elcano/Sonar/README.md

# Sonar
Range data from an array of ultra-sonic sensors
