elcano/Sonar/Documentation/Sonar_css427_wi2015.pdf

## Scott Stewart, Tim Galvin T. Folsom CSS 427 13 March 2015

# Range Sensor

# Problem Addressed

## The problem addressed by our team was to develop and test the functionality of a sonar board for use in the Elcano project. The sonar board uses multiple sonar sensors simultaneously to gather range data of its surrounding environment. Each sonar board uses

eight sonar sensors: one at each hour of the top half of the clock, and one behind.

## Harmonious operation of sonar sensors, their scope, and communication were problems to

address.

# Work to be Done

Existing datasheets and empirical data were to be used to determine a correct manner to poll sensors in a way that is efficient. The datasheets were also to be used to analyze any overlap of the sonar sensors. Code needed to be written to handle the coordination of the timing of the sonar sensors and the communication between them and the microcontroller using SPI. The code was to be robust and usable by others that work on the Elcano project.

# Solution

## Software Design

Our solution uses an Arduino microcontroller to communicate with the sonar board using SPI bus to coordinate the sonar sensors. The sonar sensors were put into groups of two or three sensors per group. A round of sensor data is gathered by simultaneously getting and reading range data from all sonar sensors in a group. The groups are pinged for data once per round in a set order. As a result, data is received in an orderly manner without much interference between sensors.

## The defined rounds of polling using position on an imaginary clock as position

| Sensor 1 | Sensor 2 | Sensor 3
Round 1 | 12 o’clock | 3 o’clock | 9 o’clock
Round 2 | 1 o’clock | 6 o’clock | 10 o’clock
Round 3 | 2 o’clock | 11 o’clock

## Rounds are handled by driving pins corresponding to a given group HIGH or LOW depending

on which group’s turn it is to get sonar data. This is handled in our setRound() function that takes two integers representing high and low order bits for each group.

The sensors themselves send a PWM signal that is read via an interrupt that records the time length of the signal. This time is then processed and converted into a range measurement in centimeters. This data is then printed.

## Test Methods

We were faced with the problem of testing whether our code worked or not without having the new sonar board on hand. As a solution, we set about building a wooden jig that would hold the sensors in their correct orientation, and allow us to get meaningful readings from them.

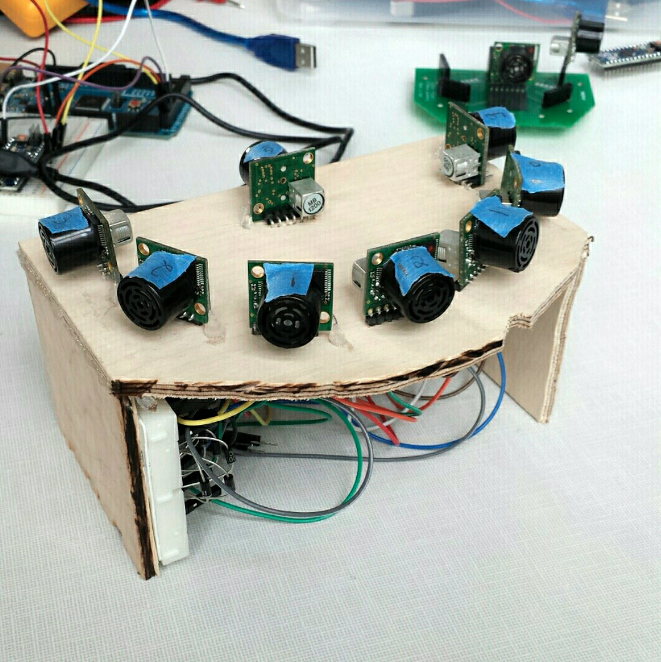
[picture p1: figure]

## Our makeshift “sonarboard”

Once we had the sensors in place, we were able to take the sonar board outside and test our ability to get raw data. In the beginning, this simply meant looking at a series of numbers in the serial monitor. This was useful data, but it was still difficult to convince ourselves that the data was legitimate without some sort of visual.

## Enter processing.org. This opensource project allows for the rapid development of

visualizations, and works very well with serial data. Using built in libraries, we were able adapt

## an example program written by Christan Marc Schmidt [1] (which shows random radii pie

slices) to read serial data and give us a visual of the data from the sonars.

## The program works by reading in a series of values from the given serial port, and then

mapping those values to the radius of a given “slice” of the pie.

Output showing obstacles at 11 and 1 o’clock.

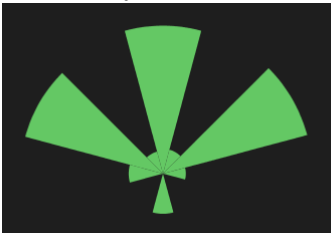
[picture p2: figure]

## We discovered that noise was rampant anytime we tested indoors, but the readings seemed

very reasonable once the board was outdoors.

## Physical/Mechanical Considerations We were aware throughout our testing that our wooden board was likely not ideal for using the sonar sensors. The sensors are angled correctly in terms of yaw, but they are able to

wiggle their pitch somewhat.

Also, our knowledge of circuitry isn’t as robust as our coding experience, and we admit there

## may be some additional circuitry needed for reliable measurements. For example, we spent

many hours wondering why we couldn’t get readings from multiple groups of sensors, only to

## find out that we needed diodes in series with the PWM output from the sensors in order to isolate them from each other. This of course will be a moot point once the new fabricated

sonar boards arrive.

## SPI Communication

We weren’t able to achieve reliable SPI communication in the time that we had. Currently the code will successfully send data over Serial from the sonar arduino.

The interaction of sending a command from the master, having the master wait for a reply, and then reliably sending the 26 bytes needed proved to be very difficult. Simple single byte communication was trivial, and we were able to get data sent from master to slave and back

## again without any issue. However, when we moved to more complicated scenarios, things became more difficult. Here is a series of steps explaining what we were hoping to accomplish:

1. The master sends a command over SPI to the slave, indicating it wants sonar values.

## 2. The slave (sonar arduino) then goes into a mode of reading values from all sonar

sensors. During this time, the master knows to stay idle.

## 3. Finally, the slave has data to send back to the master and begins transmission back

over SPI.
4. The master is intelligent enough to know that the real data has begun being sent back, and stores the data accordingly.

## 5. The communication ends, the slave goes back into idle, and the master does what it

needs to with the data.

## References

## 1. Example Piechart with random radii. http://www.openprocessing.org/sketch/49035

## Source Code

We will post the code here for reporting’s sake, but we will also send the .ino files via Canvas message.

/*sonarboard*/
#defineIRQ2_PIN1 //pulse10,11or12 #defineIRQ2_ID3 //TheinterruptIDrelatingtopin1

#defineIRQ3_PIN0 //Pulseon6or9 #defineIRQ3_ID2 //TheinterruptIDrelatingtopin0

#defineSDA_PIN2// I2CSDA

#defineIRQ1_SCL_PIN3 //Pulseon1,2,or3;orI2C

#defineIRQ1_ID0 | //TheinterruptIDrelatingtopin3

#defineSNR_10_PIN4 //Analogin6isSonar10 #definePWR_SEL_PIN 5 //Use5Vor3.3V #defineSNR_11_PIN6 //Analogin7

#defineRND0_PIN | 11//Loworderbitforselectingtheround

#defineRND1_PIN | 7 //Hibitofroundselect

#definePWR_ON_PIN | 8 //Applypowertosonars

#defineFRONT_PIN | 9 //Donotdisturbifhigh

#defineREAR_PIN | 10 //Donotdisturbifhigh

#defineSNR_SEL_PIN SS //Chipselectfromhostprocessor #defineSNR_SI_PIN MOSI//Thisprocessor'sserialinput

#defineSNR_SO_PIN | MISO//Thisprocessor'sserialoutput

//#defineSNR_12_PIN | A0

//Inthisversionofthecode,weuseA1-A3to //Signalwhichsensorsshouldbetriggeredineach //round.Oncetherealboardarrives,thesecanbe //reclaimedastheroundswillbecontrolledby //ciruitryconnectedtotheRND0_PINandRND1_PINpins
#defineGROUP1_PIN | A1

#defineGROUP2_PIN | A2

#defineGROUP3_PIN | A3

//#defineGROUP2_SEL | A4
//#defineGROUP3_SEL | A5
//#defineSNR_3_PIN | A3
//#defineSNR_6_PIN | A4
//#defineSNR_9_PIN | A5

#defineTIMEOUT_PERIOD100//ms #defineROUND_DELAY100//msbetweenrounds,seemstohelpstability

//Whentrue,senddataoverSerial,falsesenddataoverSPI #defineDEBUGtrue

//WhensedningoverSerial,truegivesverboseoutput #defineVERBOSE_DEBUGfalse

/*Twoboardscanhold12sonarsonthepointsofaclock. ThefrontboardholdsSonar12(straightahead) and1,2,and3Ftotheright.
Italsoholds9F,10,and11totheleft. Therearfacingboardholds3Rthrough9R,with6Rpointingback.

ThefrontsonarboardusestheSPIinterfacetoappearasaslavetoahost computer.
Whenthehostasksforsonarreadings,thefrontboardsendsalldata.

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

Theremaybenorearboardpresent. Inthiscase,thefrontboardmayusethe9F socket.

Sonarsaregroupedintothreeroundssothatmultiplesonarscanfiresimultaneously and
notinteferewitheachother.Roundsareselectedbythe(RND0,RND1)signal, whichisusedasaGraycode(onlyonebitchangesatatime).

Round | Sonars

### 00 none

01 12,3,9
11 1,6,10
10 2,11
Aroundmayfireupto3sonars.Thesonarrangemaybereportedaseitherananalog value
orasapulsewidth.Apulsewidthwillcauseaninterrupt. Therearethreeinterrupthandlers,oneforeachsonarfiredintheround.
*/
//ModifyEXPECTED_SIGNALStomtchwhichsonarsareontheboard. #defineEXPECTED_SIGNALS13
#defineEXPECTED_SIGNALS23

#defineEXPECTED_SIGNALS32

#defineSTATE_INITIAL0

#defineSTATE_READY 1

#defineSTATE_ROUND1 2

#defineSTATE_ROUND2 3

#defineSTATE_ROUND3 4

#defineCOMMAND_GO1

#defineRANGE_DATA_SIZE13

#include"pins_arduino.h"

byteBoardCount=1; //justthefrontboard byteState=STATE_INITIAL;//initializing volatilebyteSignalsReceived; volatileunsignedlongtimeLeft; volatileunsignedlongtimeRight; volatileunsignedlongtimeBehind; volatileunsignedlongtimeStart; volatilebooleantimeStartSet; volatilebytevalueIn;
volatilebooleanprocessIt;

intrange[RANGE_DATA_SIZE]={0,0,0,0,0,0,0,0,0,0,0,0,0}; introundCount=0,timeoutStart=0,timeSinceLastRound=0; volatileintisr1Count,isr2Count,isr3Count;

voidsetup()
{
//SPISetup
pinMode(MISO,OUTPUT);
SPCR|=_BV(SPE);//turnonSPIinslavemode SPCR|=_BV(SPIE);//turnoninterruptsforSPI processIt=false;//falseuntilwehavearequesttoprocess

timeLeft=timeRight=timeBehind=timeStart=0; isr1Count=isr2Count=isr3Count=0; timeStartSet=false;
Serial.begin(115200);
pinMode(A1,OUTPUT);
pinMode(A2,OUTPUT);
pinMode(A3,OUTPUT);
pinMode(0,INPUT);
pinMode(1,INPUT);
pinMode(3,INPUT);
State=STATE_INITIAL;
BoardCount=1;
// | digitalWrite(RND0_PIN,LOW);
// | digitalWrite(RND1_PIN,LOW);
setRound(0,0);
digitalWrite(FRONT_PIN,HIGH); //signalrearboardthatwearehere;Seeifthere isarearboard
//select5Vpower
digitalWrite(PWR_SEL_PIN,HIGH);
//turnonsonars
digitalWrite(PWR_ON_PIN,HIGH);
// | for(inti=0;i<1000;i++)
// | { //Seeifthereisasecondboard
// | byteRear=digitalRead(REAR_PIN);
// | if(Rear==HIGH)
// | {
// | BoardCount=2;
// | //needtodynamicallyattach/detacyIRQ1_SCL_PINsothatitisshared
betweenIntRightandI2C
// | break;
// | }
// | }
| delay(200);//Personardatasheet,needs175msforboot
| attachInterrupt(IRQ2_ID,IsrLeft,CHANGE);
| attachInterrupt(IRQ3_ID,IsrBehind,CHANGE);
| if(BoardCount==1)
| {//don'tneedD3forI2C
| attachInterrupt(IRQ1_ID,IsrRight,CHANGE);
}
| digitalWrite(FRONT_PIN,LOW);//openforbusiness
| State=STATE_READY;
}

//SPIinterruptroutine
ISR(SPI_STC_vect){

valueIn=SPDR; //grabbytefromSPIDataRegister processIt=true;
}

voidIsrLeft()
{ //ISRforendofpulseonsonar10,11or12 isr1Count++;
noInterrupts();
SignalsReceived++;
if(digitalRead(IRQ2_PIN)==HIGH&&timeStartSet==false) {
timeStart=micros();
timeStartSet=true;
}
else
{
timeLeft=micros();
}
interrupts();
}
voidIsrBehind()
{ //ISRforendofpulseonsonar6or9 isr2Count++;
noInterrupts();
SignalsReceived++;
if(digitalRead(IRQ3_PIN)==HIGH&&timeStartSet==false) {
timeStart=micros();
timeStartSet=true;
}
else
{
timeBehind=micros();
}
interrupts();
}
voidIsrRight()
{//ISRforendofpulseonsonar1,2or3 //Logtimeofthepulseend
isr3Count++;
noInterrupts();
SignalsReceived++;
if(digitalRead(IRQ1_SCL_PIN)==HIGH&&timeStartSet==false) {
timeStart=micros();
timeStartSet=true;
}
else

{
timeRight=micros();
}
interrupts();
}

voidloop()
{
State=STATE_READY;
// | digitalWrite(RND0_PIN,LOW);
// | digitalWrite(RND1_PIN,LOW);
| setRound(0,0);
//readInput(); | //Sonarisslavewaitingforcommandfrommaster
//TODO:Sendstartsignaltorearboard.

//******Round1*******
State=STATE_ROUND1;
SignalsReceived=0;
//sendapulseonsonars
interrupts();
setRound(0,1);
// digitalWrite(RND1_PIN,HIGH);

timeoutStart=millis();
while(SignalsReceived<EXPECTED_SIGNALS1)
{
if((millis()-timeoutStart)>TIMEOUT_PERIOD)break; }
delay(ROUND_DELAY);
timeStartSet=false;
range[12]=(timeLeft-timeStart)/58; range[3] =(timeRight-timeStart)/58; range[9] =(timeBehind-timeStart)/58;

//******Round2*******
State=STATE_ROUND2;
SignalsReceived=0;
// | digitalWrite(RND0_PIN,HIGH);
// | sendapulseonsonars
| setRound(1,1);
| timeoutStart=millis();
| while(SignalsReceived<EXPECTED_SIGNALS2)
{

if((millis()-timeoutStart)>TIMEOUT_PERIOD)break; }
delay(ROUND_DELAY);
timeStartSet=false;
range[10]=(timeLeft-timeStart)/58; range[1] =(timeRight-timeStart)/58; range[6] =(timeBehind-timeStart)/58;

//******Round3*******
State=STATE_ROUND3;
// | digitalWrite(RND1_PIN,LOW);
| SignalsReceived=0;
| //sendapulseonsonars
| setRound(0,1);
| timeoutStart=millis();
| while(SignalsReceived<EXPECTED_SIGNALS3)
{
| if((millis()-timeoutStart)>TIMEOUT_PERIOD)break;
}
| delay(ROUND_DELAY);
| timeStartSet=false;
| range[2]=(timeLeft-timeStart)/58;
| range[11] =(timeRight-timeStart)/58;

// //TODO:Receivedatafromrearboard
| writeOutput();
| State=STATE_READY;
| roundCount++;
| //delay(120);
// | return;
}

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

digitalWrite(A3,LOW);
}elseif(highOrderBit==0&&lowOrderBit==1) {
//12,3,9
digitalWrite(A1,HIGH);
digitalWrite(A2,LOW);
digitalWrite(A3,LOW);
delay(10);
digitalWrite(A1,LOW);
}elseif(highOrderBit==1&&lowOrderBit==0) {
//2,11
digitalWrite(A1,LOW);
digitalWrite(A2,HIGH);
digitalWrite(A3,LOW);
delay(10);
digitalWrite(A2,LOW);
}elseif(highOrderBit==1&&lowOrderBit==1) {
//1,6,10
digitalWrite(A1,LOW);
digitalWrite(A2,LOW);
digitalWrite(A3,HIGH);
delay(10);
digitalWrite(A3,LOW);
}
}
voidreadInput()
{
byteselect;
//waitforhosttorequestinformation do
{
select=digitalRead(SNR_SEL_PIN);
}while(select==HIGH);
if(DEBUG)return;
while(!processIt||valueIn!=COMMAND_GO);//stayinroutineuntilcommandedto startonMOSI
processIt=false;
}

voidwriteOutput()
{
if(DEBUG){
if(VERBOSE_DEBUG){
Serial.print("Round:");
Serial.print(roundCount);
Serial.print("millis:");

Serial.print(millis());
Serial.print(",millissincelast:"); Serial.print(millis()-timeSinceLastRound); timeSinceLastRound=millis(); Serial.print(",SigReceived:"); Serial.print(SignalsReceived); Serial.print(",isr1:");
Serial.print(isr1Count);
Serial.print(",isr2:");
Serial.print(isr2Count);
Serial.print(",isr3:");
Serial.print(isr3Count);
Serial.print("Vals:");
}
for(inti=1;i<13;++i)
{
Serial.print(range[i]);
Serial.print("");
}
Serial.println();
}
else
{
//HereiswheredatawillbesentoverSPI.Stillneedswork intdataPos=0;
processIt=false;
while(dataPos<RANGE_DATA_SIZE){ inttimeStart=millis();
while(!processIt){
if(millis()-timeStart>TIMEOUT_PERIOD)break; }
writeIntData(range[dataPos++]);
delay(20);
}
dataPos=0;
}
}

//SendtwobytesoverSPIinordertorepresentanint voidwriteIntData(intdata)
{
bytehighOrderByte=(byte)(data>>8); bytelowOrderByte=(byte)data;

//Sendfirstbyte
SPDR=highOrderByte;
processIt=false;

//WaitforSPIinterruptbeforesedningsecondbyte while(!processIt)
{
if(millis()-timeStart>TIMEOUT_PERIOD)break; }
//Sendsecondbyte
SPDR=lowOrderByte;
processIt=false;
}
