elcano/Sonar/Electronics/SonarBoM_V3.xlsx

Partlist
Exported from SonarBoard Updated.brd at 12/9/2019 8:38 PM
EAGLE Version 9.5.1 Copyright (c) 1988-2019 Autodesk | Inc.
Assembly variant:
Part | Value | Package | Library | Position | Link
C9
C10 | 0.1uF | C025-024X044 | adafruit | (2850.49975 245.19993) R0
C12 | 10uF | C025-024X044 | adafruit | (1429.29995 915.80007) R90
C13 | 10uF | C025-024X044 | adafruit | (2596.0999 246.39998) R0
C14 | DNS | C025-024X044 | adafruit | (2646 115.8002) R0
C16 | 0.1uF | C025-024X044 | adafruit | (2872.89998 1591.50012) R0
C17 | 0.1uF | C025-024X044 | adafruit | (2873.29995 1710.20017) R0
C18 | .1uF | C025-024X044 | rcl | (992.79995 78.79995) R0
C19 | 0.1uF | C025-024X044 | rcl | (992.79995 187.80007) R180
C20 | 0.1uF | C025-024X044 | rcl | (2898.60002 117.9001) R0
C21 | 0.1uF | C025-024X044 | rcl | (3103.2003 245.99988) R0
C22 | 0.1uF | C025-024X044 | rcl | (3149.00012 116.5) R180
C23 | 0.1uF | C025-024X044 | adafruit | (2873.09978 1841.80007) R0
CAN_CLK1 | ECS-160-20-46X | XTAL_ECS-160-20-46X | ECS-160-20-46X | (3466.30007 228.79983) R90
J2 | CAN-PLUG | SCREWTERMINAL-3.5MM-4 | SparkFun-Connectors | (1667.89998 152.70005) R180
J5 | HEAD17-NOSS | HEAD17-NOSS | SmartPrj | (1830.45399 1747.20005) R270
J6 | HEAD17-NOSS-1 | HEAD17-NOSS-1 | SmartPrj | (2428.20399 1747.94993) R270
LED1 |  | LED3MM | adafruit | (616.30007 651.99988) R180
LED2 |  | LED3MM | adafruit | (922.19993 1770.20005) R180
LP38693MP-ADJ | LP38693MP-ADJ | SOT150P696X180-5N | ElcanoProject | (634.9001 907.69993) R0
MCP2510 | MCP2510 | DIL18 | microchip_can | (2134.19993 501.89998) R270
MCP2551 | MCP2551 | DIL08 | MCP2551 | (974.39998 631.40022) R90
R2 | 20k | 0207/9 | adafruit | (1455.10002 557.30007) R270
R3 | 1k | 0207/9 | adafruit | (1635.20017 776.0999) R270
R4 | 120 | 0207/9 | adafruit | (1287.29995 557.79995) R90
R6 | 10k | 0207/9 | adafruit | (945.10015 349.80007) R180
R16 | 600 | 0207/9 | adafruit | (2596.5 1986.10002) R270
R17 | DNS | 0207/9 | adafruit | (2586.70005 1301.30007) R90
R18 | 100k | 0207/9 | adafruit | (677.30007 1151.89998) R180
R19 | DNS | 0207/9 | adafruit | (671.19993 1296.10002) R0
R20 | 33k | 0207/9 | adafruit | (2228.80007 2215.69993) R0
R21 | 12k | 0207/9 | adafruit | (1741.29995 2215.70005) R0
R22 | 600 | 0207/9 | adafruit | (1104.00012 1996.70017) R180
R23 | 0 | 0207/9 | adafruit | (3055.30007 1451.99988) R180
S01 | MaxSonar | XL-MAXSONAR-PACKAGE | ElcanoProject | (2850 2269.92126) R150
S02 | MaxSonar | XL-MAXSONAR-PACKAGE | ElcanoProject | (3490 1624.92126) R120
S03 | MaxSonar | XL-MAXSONAR-PACKAGE | ElcanoProject | (3720 784.92126) R90
S06 | MaxSonar | XL-MAXSONAR-PACKAGE | ElcanoProject | (466.50012 159.29995) R0
S09 | MaxSonar | XL-MAXSONAR-PACKAGE | ElcanoProject | (220 799.92126) R270
S10 | MaxSonar | XL-MAXSONAR-PACKAGE | ElcanoProject | (450 1629.92126) R240
S11 | MaxSonar | XL-MAXSONAR-PACKAGE | ElcanoProject | (1100 2279.92126) R210
S12 | MaxSonar | XL-MAXSONAR-PACKAGE | ElcanoProject | (1968.50394 2508.38583) R180
TP1 | TPPAD1-17 | P1-17 | testpad | (620.49988 1469.99988) R0
TP2 | TPPAD1-17 | P1-17 | testpad | (767.6998 1468.70005) R270
TP3 | TPPAD1-17 | P1-17 | testpad | (213.00037 1304.4001) R0
U1 | SN74LS245N | N20 | SN74LS245 | (1979.1998 2012.70017) R180 | https://www.digikey.com/product-detail/en/texas-instruments/SN74LS245N/296-1655-5-ND/277301
U2 | SN74LS245N | N20 | SN74LS245 | (1681.89998 1154.20005) R0
U4 | SN74LS14N | N14 | SN74LS14 | (2678.5 1058.39998) R180 | https://www.digikey.com/product-detail/en/texas-instruments/SN74LS14N/296-1643-5-ND/277289
U8 | SN74LS139AN | N16 | SN74LS139AN | (3104.3002 1210.4001) R180 | https://www.digikey.com/product-detail/en/texas-instruments/SN74LS139AN/296-1640-5-ND/277286
U9 | CD4075BEG4 | N14 | CD4075BE | (964.29983 1564) R180 | https://www.digikey.com/product-detail/en/texas-instruments/CD4075BEG4/CD4075BEG4-ND/1691340
