elcano/Sonar/Electronics/SonarBoardV3.brd

## EAGLE design Electronics/SonarBoardV3.brd (2019-12-10)

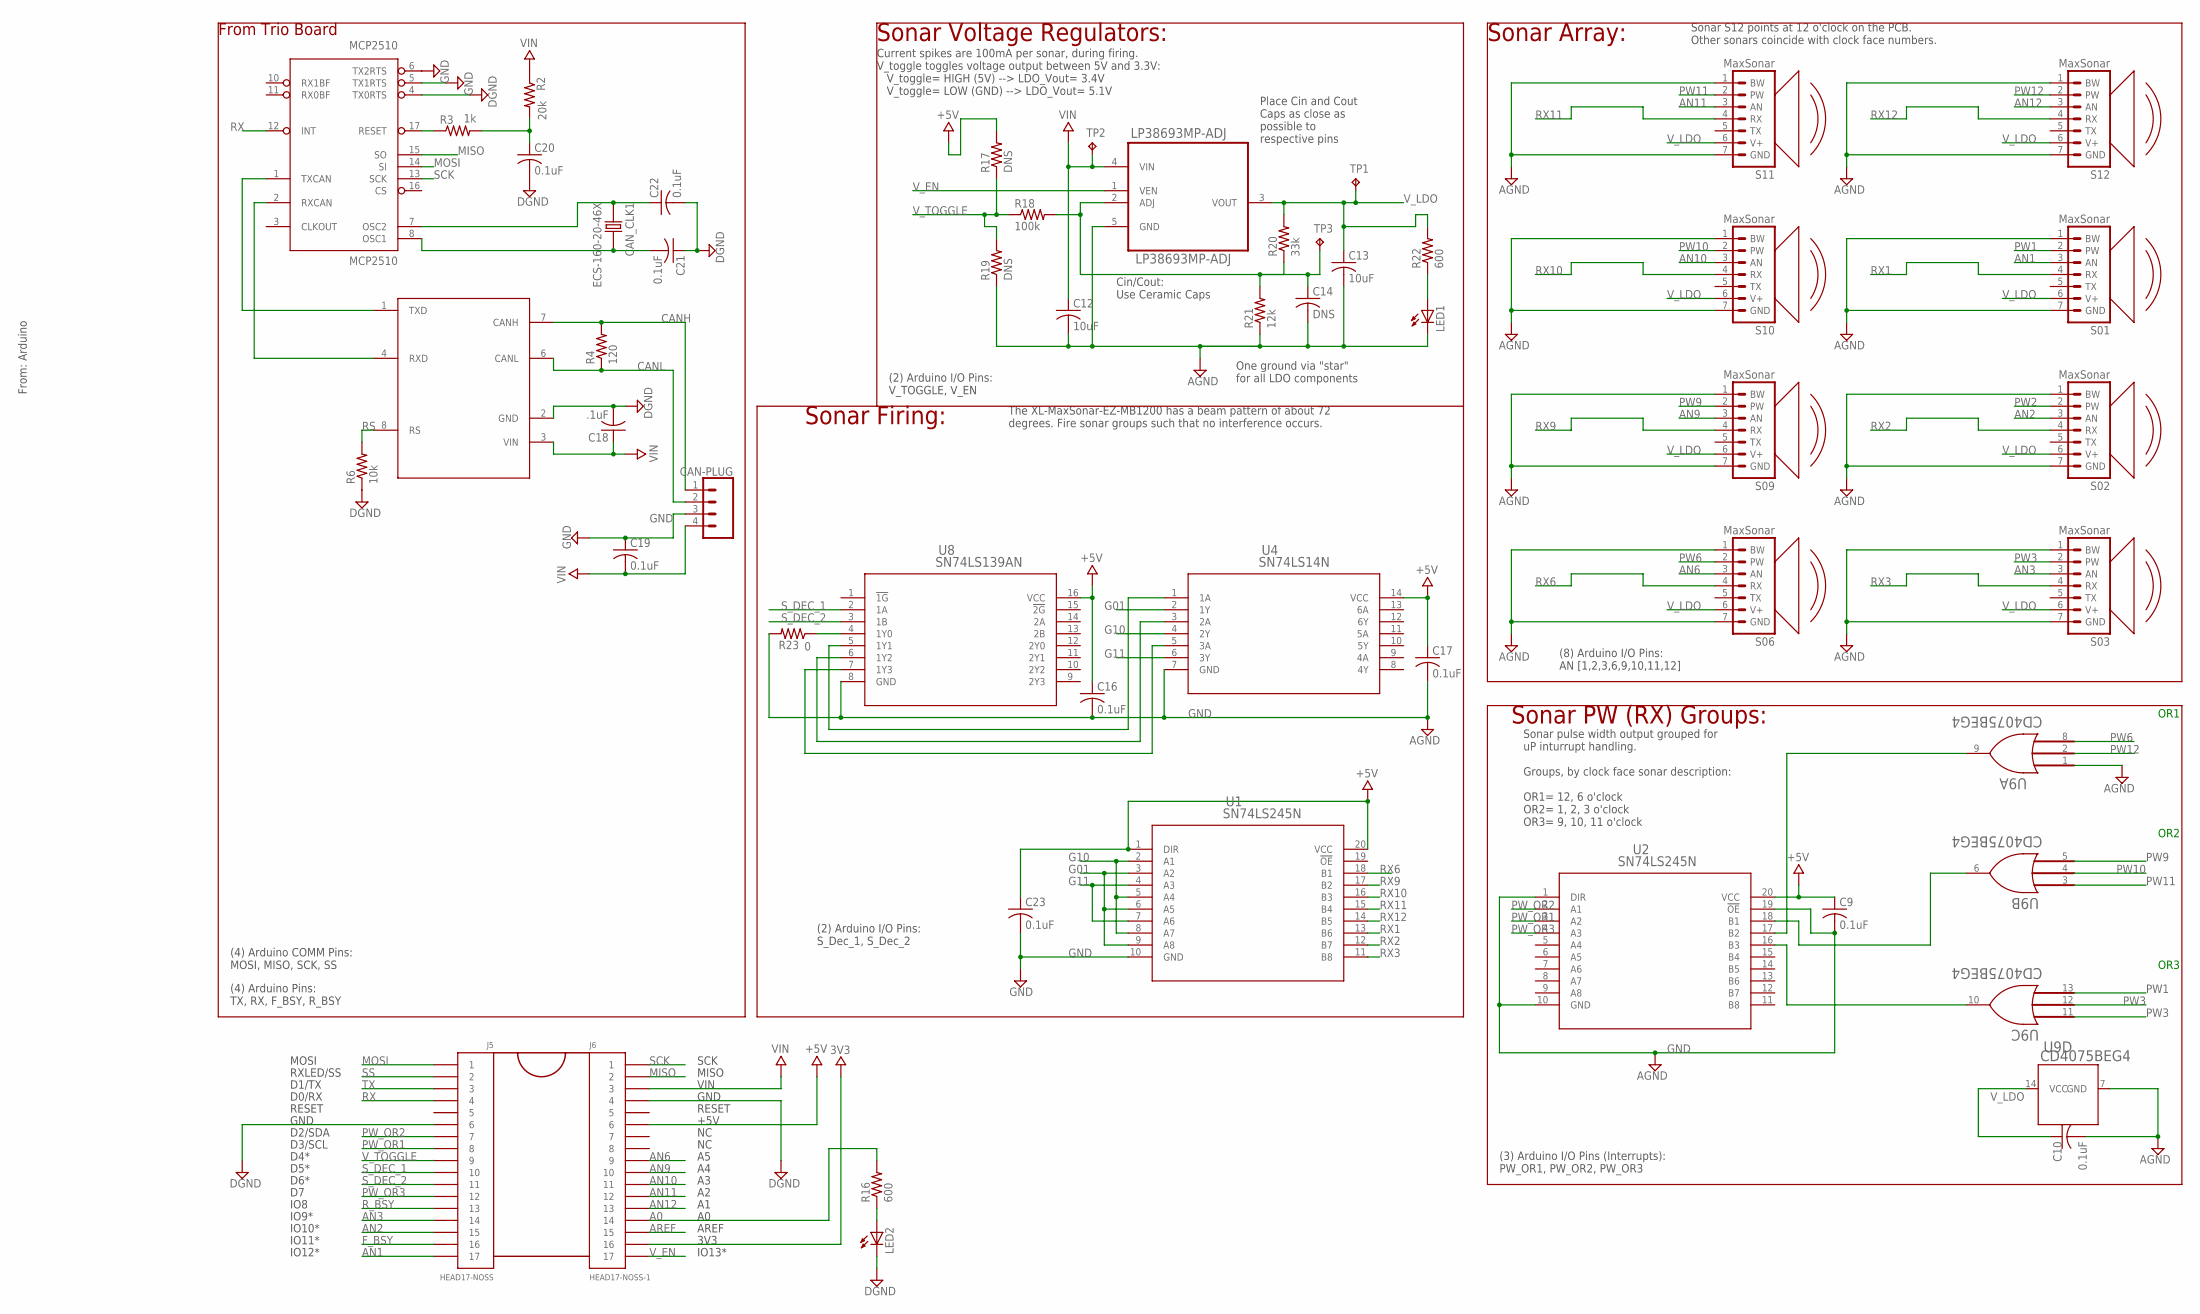
[picture p3: schematic SonarBoardV3.sch]

Parts:
C9, C10, C16, C17, C19, C20, C21, C22, C23: 0.1uF; C025-024X044
C12, C13: 10uF; C025-024X044
C14: DNS; C025-024X044
C18: .1uF; C025-024X044
CAN_CLK1: ECS-160-20-46X; XTAL_ECS-160-20-46X
J2: CAN-PLUG; SCREWTERMINAL-3.5MM-4
J5: HEAD17-NOSS
J6: HEAD17-NOSS-1
LED1, LED2: LED3MM
LP38693MP-ADJ: LP38693MP-ADJ; SOT150P696X180-5N
MCP2510: MCP2510; DIL18
MCP2551: MCP2551; DIL08
R2: 20k; 0207/9
R3: 1k; 0207/9
R4: 120; 0207/9
R6: 10k; 0207/9
R16, R22: 600; 0207/9
R17, R19: DNS; 0207/9
R18: 100k; 0207/9
R20: 33k; 0207/9
R21: 12k; 0207/9
R23: 0; 0207/9
S01, S02, S03, S06, S09, S10, S11, S12: MaxSonar; XL-MAXSONAR-PACKAGE
TP1, TP2, TP3: TPPAD1-17; P1-17
U1, U2: SN74LS245N; N20
U4: SN74LS14N; N14
U8: SN74LS139AN; N16
U9: CD4075BEG4; N14

Connections:
3V3: J6.16
+5V: C9.1, C16.1, C17.1, C23.1, J6.6, R17.2, U1.1 (DIR), U1.20 (VCC), U2.20 (VCC), U4.14 (VCC), U8.16 (VCC)
A0: J6.14, R16.2
AN1: J5.17, S01.3 (AN)
AN2: J5.15, S02.3 (AN)
AN3: J5.14, S03.3 (AN)
AN6: J6.9, S06.3 (AN)
AN9: J6.10, S09.3 (AN)
AN10: J6.11, S10.3 (AN)
AN11: J6.12, S11.3 (AN)
AN12: J6.13, S12.3 (AN)
AREF: J6.15
CANH: J2.1, MCP2551.7 (CANH), R4.2
CANL: J2.2, MCP2551.6 (CANL), R4.1
F_BSY: J5.16
G01: U1.3 (A2), U1.6 (A5), U1.9 (A8), U4.2 (1Y)
G10: U1.2 (A1), U1.5 (A4), U1.8 (A7), U4.4 (2Y)
G11: U1.4 (A3), U1.7 (A6), U4.6 (3Y)
GND: C9.2, C10.2, C12.2, C13.2, C14.2, C16.2, C17.2, C18.2, C19.1, C20.2, C21.1, C22.2, C23.2, J2.3, J5.6, J6.4, LED1.K (C), LED2.K (C), LP38693MP-ADJ.5 (GND), MCP2510.4 (TX0RTS), MCP2510.5 (TX1RTS), MCP2510.6 (TX2RTS), MCP2551.2 (GND), R6.1, R19.1, R21.1, R23.2, S01.1 (BW), S01.7 (GND), S02.1 (BW), S02.7 (GND), S03.1 (BW), S03.7 (GND), S06.1 (BW), S06.7 (GND), S09.1 (BW), S09.7 (GND), S10.1 (BW), S10.7 (GND), S11.1 (BW), S11.7 (GND), S12.1 (BW), S12.7 (GND), U1.10 (GND), U2.1 (DIR), U2.10 (GND), U2.19 (!OE), U4.7 (GND), U8.8 (GND), U9.7 (GND)
MISO: J6.2, MCP2510.15 (SO)
MOSI: J5.1, MCP2510.14 (SI)
unnamed: U4.5 (3A), U8.7 (1Y3)
unnamed: LED2.A, R16.1
unnamed: U2.16 (B3), U9.10 (J)
unnamed: C21.2, CAN_CLK1.2, MCP2510.8 (OSC1)
unnamed: U4.3 (2A), U8.6 (1Y2)
unnamed: LED1.A, R22.1
unnamed: U4.1 (1A), U8.5 (1Y1)
unnamed: C22.1, CAN_CLK1.1, MCP2510.7 (OSC2)
unnamed: MCP2510.2 (RXCAN), MCP2551.4 (RXD)
unnamed: MCP2510.1 (TXCAN), MCP2551.1 (TXD)
unnamed: MCP2510.17 (RESET), R3.1
unnamed: C20.1, R2.2, R3.2
unnamed: R23.1, U8.4 (1Y0)
unnamed: U2.17 (B2), U9.9 (J)
unnamed: U2.18 (B1), U9.6 (J)
PW1: S01.2 (PW)
PW2: S02.2 (PW)
PW3: S03.2 (PW)
PW6: S06.2 (PW)
PW9: S09.2 (PW)
PW10: S10.2 (PW)
PW11: S11.2 (PW)
PW12: S12.2 (PW)
PW_OR1: J5.8, U2.3 (A2)
PW_OR2: J5.7, U2.2 (A1)
PW_OR3: J5.12, U2.4 (A3)
RS: MCP2551.8 (RS), R6.2
RX: J5.4, MCP2510.12 (INT)
RX1: S01.4 (RX), U1.13 (B6)
RX2: S02.4 (RX), U1.12 (B7)
RX3: S03.4 (RX), U1.11 (B8)
RX6: S06.4 (RX), U1.18 (B1)
RX9: S09.4 (RX), U1.17 (B2)
RX10: S10.4 (RX), U1.16 (B3)
RX11: S11.4 (RX), U1.15 (B4)
RX12: S12.4 (RX), U1.14 (B5)
R_BSY: J5.13
SCK: J6.1, MCP2510.13 (SCK)
SS: J5.2
S_DEC_1: J5.10, U8.2 (1A)
S_DEC_2: J5.11, U8.3 (1B)
TX: J5.3
VIN: C12.1, C18.1, C19.2, J2.4, J6.3, LP38693MP-ADJ.4 (VIN), MCP2551.3 (VIN), R2.1, TP2.TP
V_ADJ: C14.1, LP38693MP-ADJ.2 (ADJ), R18.2, R20.1, R21.2, TP3.TP
V_EN: J6.17, LP38693MP-ADJ.1 (VEN)
V_LDO: C10.1, C13.1, LP38693MP-ADJ.3 (VOUT), R20.2, R22.2, S01.6 (V+), S02.6 (V+), S03.6 (V+), S06.6 (V+), S09.6 (V+), S10.6 (V+), S11.6 (V+), S12.6 (V+), TP1.TP, U9.14 (VCC)
V_TOGGLE: J5.9, R17.1, R18.1, R19.2

Notes on the sheet:
Sonar S12 points at 12 o'clock on the PCB. Other sonars coincide with clock face numbers.
From Trio Board
The XL-MaxSonar-EZ-MB1200 has a beam pattern of about 72 degrees. Fire sonar groups such that no interference occurs.
Sonar Voltage Regulators:
Place Cin and Cout Caps as close as possible to respective pins
One ground via "star" for all LDO components
Current spikes are 100mA per sonar, during firing. V_toggle toggles voltage output between 5V and 3.3V: V_toggle= HIGH (5V) --> LDO_Vout= 3.4V V_toggle= LOW (GND) --> LDO_Vout= 5.1V
Cin/Cout: Use Ceramic Caps
From: Arduino
Sonar Firing:
Sonar Array:
(2) Arduino I/O Pins: S_Dec_1, S_Dec_2
(2) Arduino I/O Pins: V_TOGGLE, V_EN
(8) Arduino I/O Pins: AN [1,2,3,6,9,10,11,12]
Sonar PW (RX) Groups:
Sonar pulse width output grouped for uP inturrupt handling. Groups, by clock face sonar description: OR1= 12, 6 o'clock OR2= 1, 2, 3 o'clock OR3= 9, 10, 11 o'clock
(3) Arduino I/O Pins (Interrupts): PW_OR1, PW_OR2, PW_OR3
(4) Arduino COMM Pins: MOSI, MISO, SCK, SS
(4) Arduino Pins: TX, RX, F_BSY, R_BSY
MOSI
RXLED/SS
D1/TX
D0/RX
RESET
GND
D2/SDA
D3/SCL
D4*
D5*
IO8
D6*
IO9*
IO10*
IO11*
IO12*
SCK
MISO
VIN
+5V
AREF
3V3
IO13*
OR1
OR2
OR3

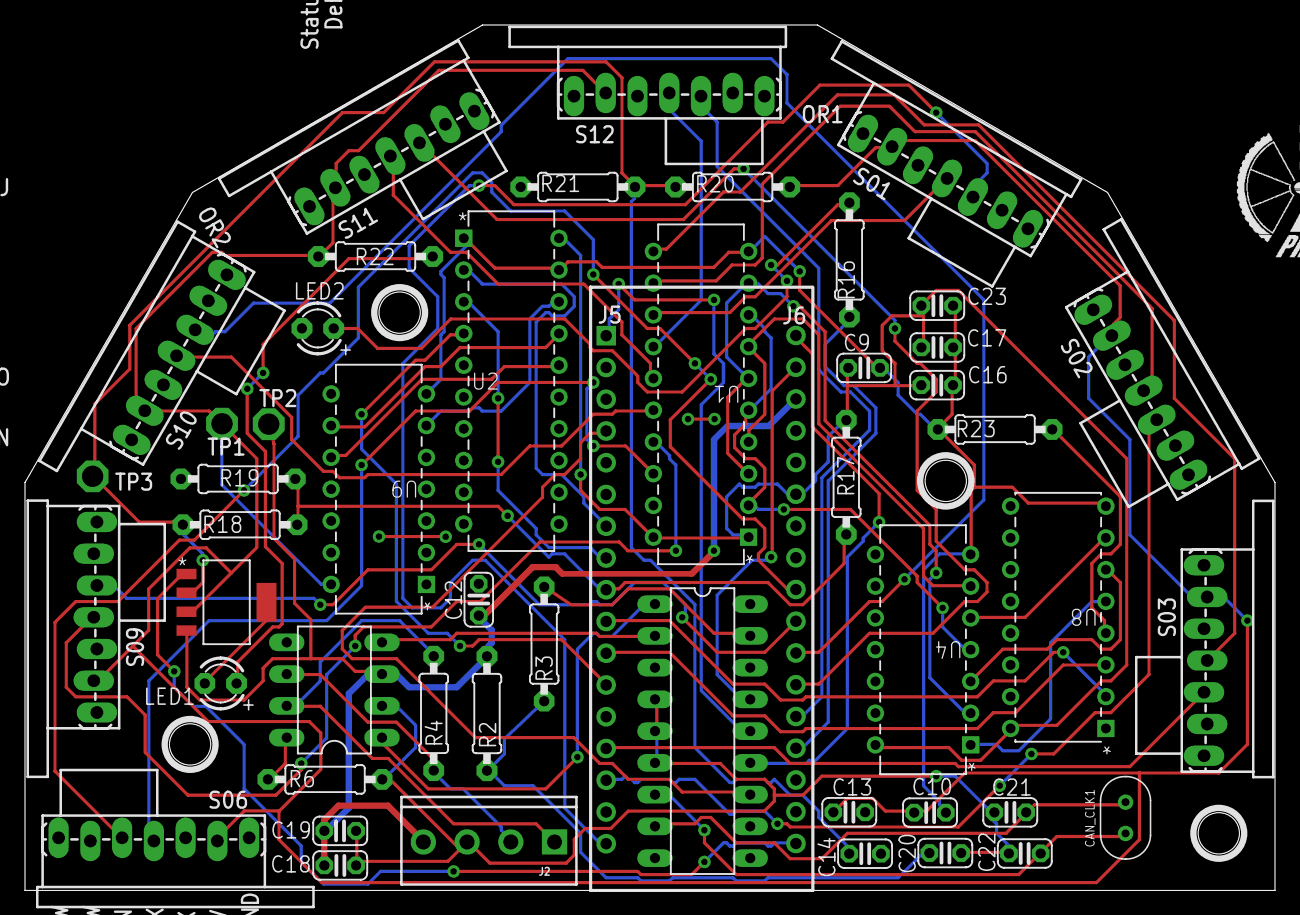
[picture p4: board SonarBoardV3.brd from above]

Board: 2 copper layers, 100.0 x 69.2 mm, 54 parts (0 on the bottom side), 54 nets.

Other parts of the board:
U$15, U$16, U$17, U$18: STAND-OFF
