elcano/Sonar/Electronics/SonarBoardV2.brd

## EAGLE design Electronics/SonarBoardV2.brd (2019-06-20, an earlier design)

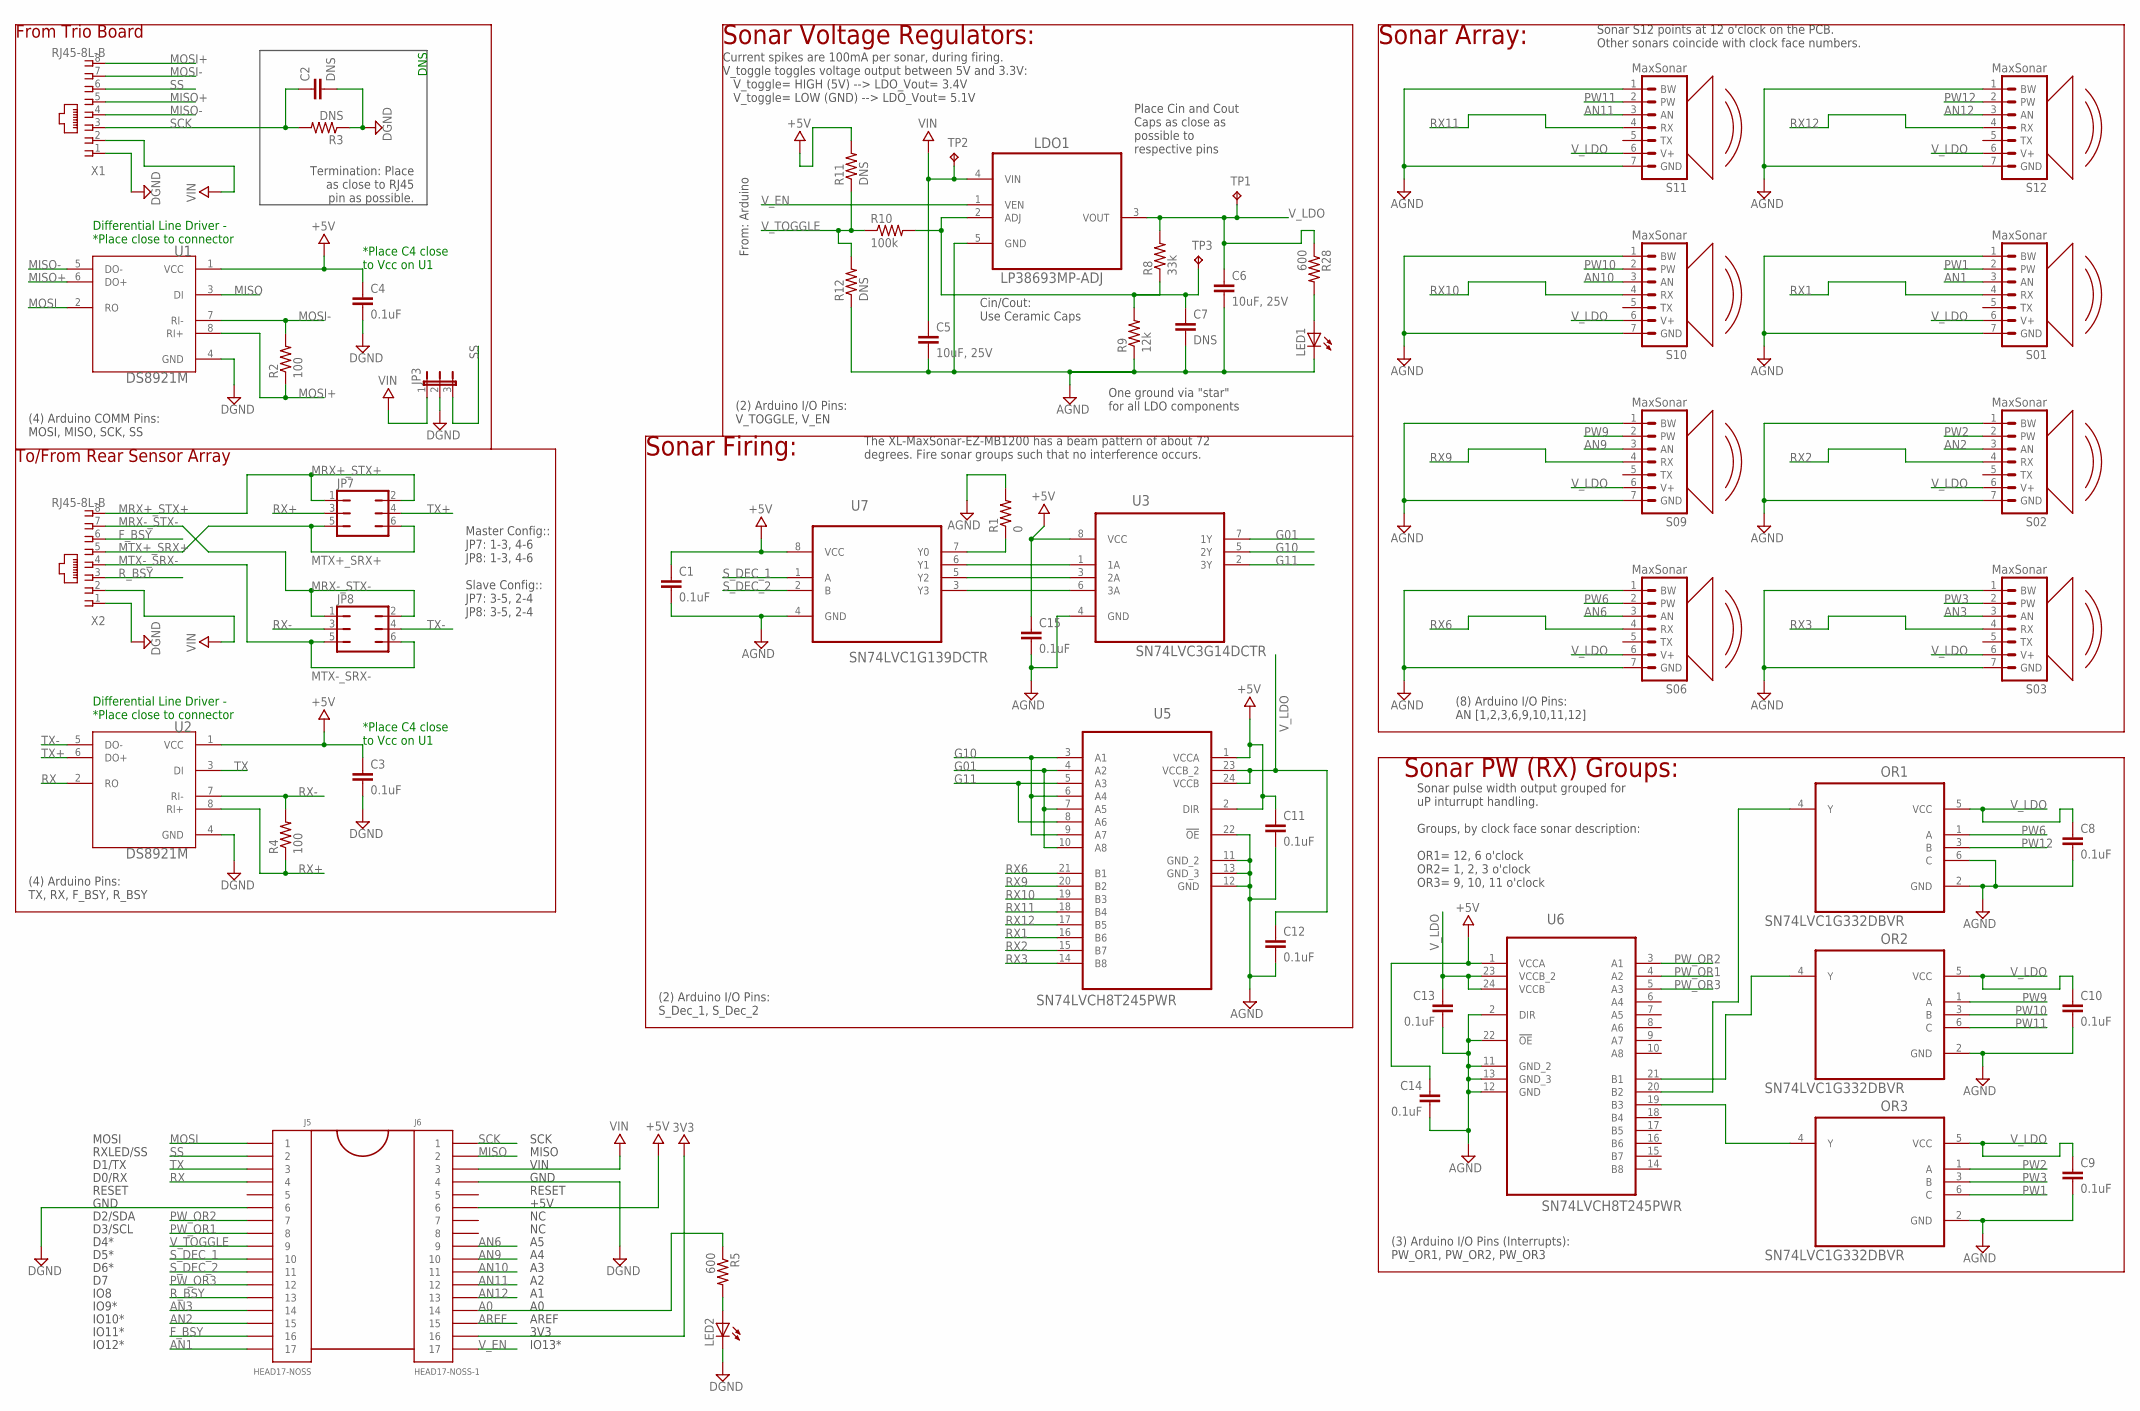
[picture p5: schematic SonarBoardV2.sch]

Parts:
C1, C3, C4, C8, C9, C10, C11, C12, C13, C14, C15: 0.1uF; 0603-CAP
C2, C7: DNS; 0603-CAP
C5, C6: 10uF, 25V; 0805
J5: HEAD17-NOSS
J6: HEAD17-NOSS-1
JP3: JP2E; JP2
JP7, JP8: JP3Q
LDO1: LP38693MP-ADJ; SOT150P696X180-5N
LED1, LED2: LEDSML0603; SML0603
OR1, OR2, OR3: SN74LVC1G332DBVR; SOT95P280X145-6N
R1: 0; 0603-RES
R2, R4: 100; R0805
R3, R11, R12: DNS; 0603-RES
R5, R28: 600; 0603-RES
R8: 33k; 0603-RES
R9: 12k; 0603-RES
R10: 100k; 0603-RES
S01, S02, S03, S06, S09, S10, S11, S12: MaxSonar; XL-MAXSONAR-PACKAGE
TP1, TP2, TP3: TPPAD1-17; P1-17
U1, U2: DS8921M; SOIC127O620X175-8N
U3: SN74LVC3G14DCTR; SOP65P400X130-8N
U5, U6: SN74LVCH8T245PWR; SOP65P640X120-24N
U7: SN74LVC1G139DCTR; SOP65P400X130-8N@1
X1, X2: RJ45-8L-B; RJ45-NO-SHIELD

Connections:
3V3: J6.16
+5V: C1.1, C3.1, C4.1, C11.1, C14.1, C15.1, J6.6, R11.2, U1.1 (VCC), U2.1 (VCC), U3.8 (VCC), U5.1 (VCCA), U5.2 (DIR), U6.1 (VCCA), U7.8 (VCC)
A0: J6.14, R5.1
AN1: J5.17, S01.3 (AN)
AN2: J5.15, S02.3 (AN)
AN3: J5.14, S03.3 (AN)
AN6: J6.9, S06.3 (AN)
AN9: J6.10, S09.3 (AN)
AN10: J6.11, S10.3 (AN)
AN11: J6.12, S11.3 (AN)
AN12: J6.13, S12.3 (AN)
AREF: J6.15
F_BSY: J5.16, X2.6
G01: U3.7 (1Y), U5.4 (A2), U5.7 (A5), U5.10 (A8)
G10: U3.5 (2Y), U5.3 (A1), U5.6 (A4), U5.9 (A7)
G11: U3.2 (3Y), U5.5 (A3), U5.8 (A6)
GND: C1.2, C2.2, C3.2, C4.2, C5.2, C6.2, C7.2, C8.2, C9.2, C10.2, C11.2, C12.2, C13.2, C14.2, C15.2, J5.6, J6.4, JP3.2, LDO1.5 (GND), LED1.C, LED2.C, OR1.2 (GND), OR1.6 (C), OR2.2 (GND), OR3.2 (GND), R1.2, R3.1, R9.1, R12.1, S01.1 (BW), S01.7 (GND), S02.1 (BW), S02.7 (GND), S03.1 (BW), S03.7 (GND), S06.1 (BW), S06.7 (GND), S09.1 (BW), S09.7 (GND), S10.1 (BW), S10.7 (GND), S11.1 (BW), S11.7 (GND), S12.1 (BW), S12.7 (GND), U1.4 (GND), U2.4 (GND), U3.4 (GND), U5.11 (GND_2), U5.12 (GND), U5.13 (GND_3), U5.22 (!OE), U6.2 (DIR), U6.11 (GND_2), U6.12 (GND), U6.13 (GND_3), U6.22 (!OE), U7.4 (GND), X1.1, X2.1
MISO: J6.2, U1.3 (DI)
MISO+: U1.6 (DO+), X1.5
MISO-: U1.5 (DO-), X1.4
MOSI: J5.1, U1.2 (RO)
MOSI+: R2.1, U1.8 (RI+), X1.8
MOSI-: R2.2, U1.7 (RI-), X1.7
MRX+_STX+: JP7.1, JP7.2, X2.8
MRX-_STX-: JP8.1, JP8.2, X2.7
MTX+_SRX+: JP7.5, JP7.6, X2.5
MTX-_SRX-: JP8.5, JP8.6, X2.4
unnamed: LED2.A, R5.2
unnamed: LED1.A, R28.2
unnamed: U3.1 (1A), U7.6 (Y1)
unnamed: U3.3 (2A), U7.5 (Y2)
unnamed: U3.6 (3A), U7.3 (Y3)
unnamed: R1.1, U7.7 (Y0)
unnamed: OR1.4 (Y), U6.20 (B2)
unnamed: OR2.4 (Y), U6.21 (B1)
unnamed: OR3.4 (Y), U6.19 (B3)
PW1: OR3.6 (C), S01.2 (PW)
PW2: OR3.1 (A), S02.2 (PW)
PW3: OR3.3 (B), S03.2 (PW)
PW6: OR1.1 (A), S06.2 (PW)
PW9: OR2.1 (A), S09.2 (PW)
PW10: OR2.3 (B), S10.2 (PW)
PW11: OR2.6 (C), S11.2 (PW)
PW12: OR1.3 (B), S12.2 (PW)
PW_OR1: J5.8, U6.4 (A2)
PW_OR2: J5.7, U6.3 (A1)
PW_OR3: J5.12, U6.5 (A3)
RX: J5.4, U2.2 (RO)
RX1: S01.4 (RX), U5.16 (B6)
RX2: S02.4 (RX), U5.15 (B7)
RX3: S03.4 (RX), U5.14 (B8)
RX6: S06.4 (RX), U5.21 (B1)
RX9: S09.4 (RX), U5.20 (B2)
RX10: S10.4 (RX), U5.19 (B3)
RX11: S11.4 (RX), U5.18 (B4)
RX12: S12.4 (RX), U5.17 (B5)
RX+: JP7.3, R4.1, U2.8 (RI+)
RX-: JP8.3, R4.2, U2.7 (RI-)
R_BSY: J5.13, X2.3
SCK: C2.1, J6.1, R3.2, X1.3
SS: J5.2, JP3.3, X1.6
S_DEC_1: J5.10, U7.1 (A)
S_DEC_2: J5.11, U7.2 (B)
TX: J5.3, U2.3 (DI)
TX+: JP7.4, U2.6 (DO+)
TX-: JP8.4, U2.5 (DO-)
VIN: C5.1, J6.3, JP3.1, LDO1.4 (VIN), TP2.TP, X1.2, X2.2
V_ADJ: C7.1, LDO1.2 (ADJ), R8.1, R9.2, R10.2, TP3.TP
V_EN: J6.17, LDO1.1 (VEN)
V_LDO: C6.1, C8.1, C9.1, C10.1, C12.1, C13.1, LDO1.3 (VOUT), OR1.5 (VCC), OR2.5 (VCC), OR3.5 (VCC), R8.2, R28.1, S01.6 (V+), S02.6 (V+), S03.6 (V+), S06.6 (V+), S09.6 (V+), S10.6 (V+), S11.6 (V+), S12.6 (V+), TP1.TP, U5.23 (VCCB_2), U5.24 (VCCB), U6.23 (VCCB_2), U6.24 (VCCB)
V_TOGGLE: J5.9, R10.1, R11.1, R12.2

Notes on the sheet:
Sonar S12 points at 12 o'clock on the PCB. Other sonars coincide with clock face numbers.
Termination: Place as close to RJ45 pin as possible.
From Trio Board
Differential Line Driver - *Place close to connector
*Place C4 close to Vcc on U1
DNS
To/From Rear Sensor Array
The XL-MaxSonar-EZ-MB1200 has a beam pattern of about 72 degrees. Fire sonar groups such that no interference occurs.
Sonar Voltage Regulators:
Place Cin and Cout Caps as close as possible to respective pins
One ground via "star" for all LDO components
Current spikes are 100mA per sonar, during firing. V_toggle toggles voltage output between 5V and 3.3V: V_toggle= HIGH (5V) --> LDO_Vout= 3.4V V_toggle= LOW (GND) --> LDO_Vout= 5.1V
Cin/Cout: Use Ceramic Caps
From: Arduino
Sonar Firing:
Sonar Array:
(2) Arduino I/O Pins: S_Dec_1, S_Dec_2
(2) Arduino I/O Pins: V_TOGGLE, V_EN
(8) Arduino I/O Pins: AN [1,2,3,6,9,10,11,12]
Sonar PW (RX) Groups:
Sonar pulse width output grouped for uP inturrupt handling. Groups, by clock face sonar description: OR1= 12, 6 o'clock OR2= 1, 2, 3 o'clock OR3= 9, 10, 11 o'clock
(3) Arduino I/O Pins (Interrupts): PW_OR1, PW_OR2, PW_OR3
(4) Arduino COMM Pins: MOSI, MISO, SCK, SS
Master Config:: JP7: 1-3, 4-6 JP8: 1-3, 4-6 Slave Config:: JP7: 3-5, 2-4 JP8: 3-5, 2-4
(4) Arduino Pins: TX, RX, F_BSY, R_BSY
MOSI
RXLED/SS
D1/TX
D0/RX
RESET
GND
D2/SDA
D3/SCL
D4*
D5*
IO8
D6*
IO9*
IO10*
IO11*
IO12*
SCK
MISO
VIN
+5V
AREF
3V3
IO13*

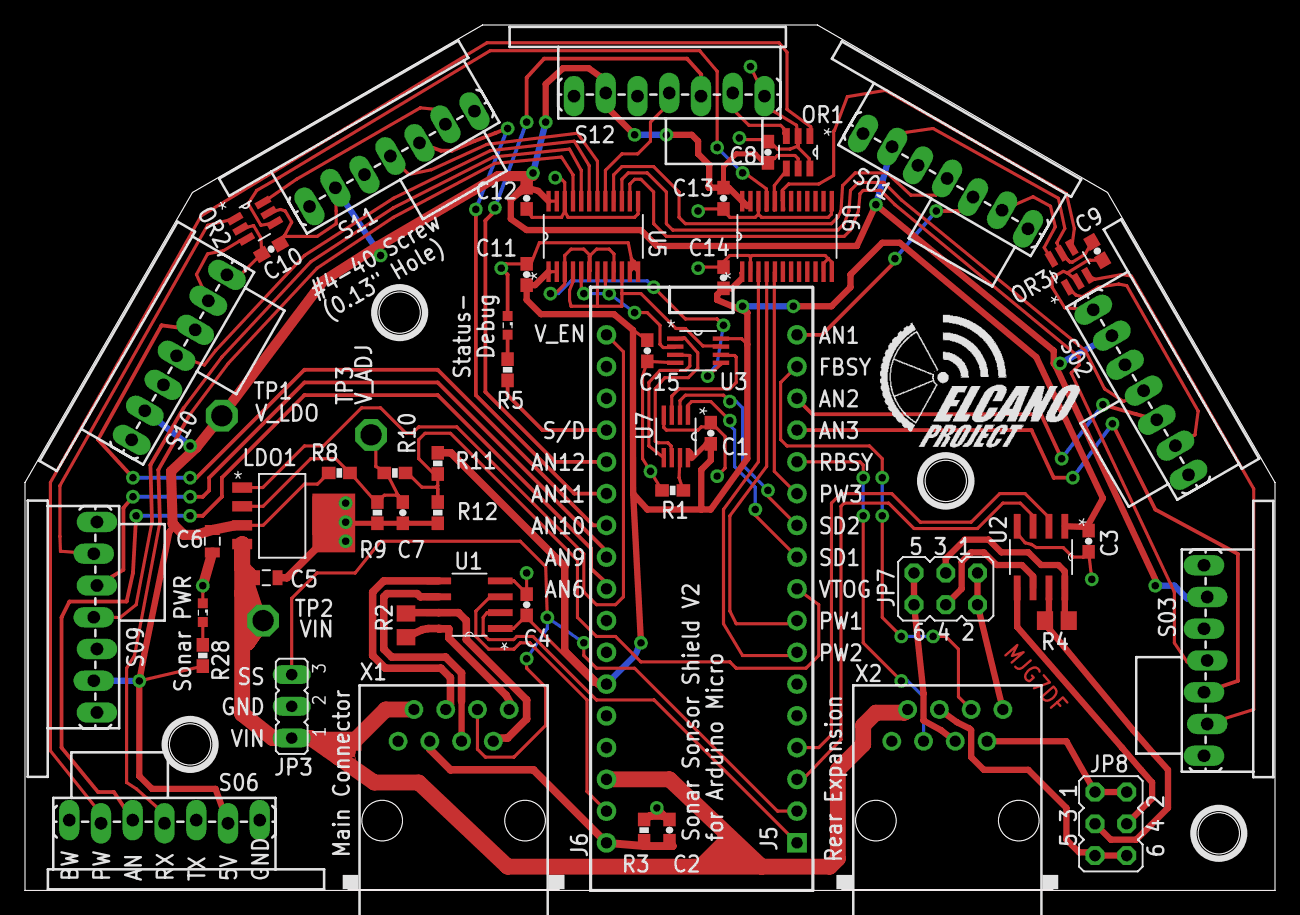
[picture p6: board SonarBoardV2.brd from above]

Board: 2 copper layers, 100.0 x 69.2 mm, 60 parts (0 on the bottom side), 69 nets.

Other parts of the board:
U$15, U$16, U$17, U$18: STAND-OFF
