elcano/Sonar/(commit log)

2019-06-20 Renamed Sonar without ElcanoC5
2019-06-20 Moved to electronics directory
    [SonarBoardV2.brd, SonarBoardV2.sch]
2019-06-20 Added relevant documentation
    [Sonars_BOM.xls]
2019-12-10 CAN design
    Michell Dean's design for moving from Version 3 (communicate on differential SPI) to Version 3 (CAN bus communications). Version 3 board has not been built.
    [SonarBoM_V3.xlsx, SonarBoardV3.brd, SonarBoardV3.sch]
